zaruthoj/preamp/BOM.ods

Description | Schematic #s | Part Number | Quantity | Price | Ext Price | Link
1000uF cap | C6, C7 | 1189-2588-ND | 3 | 0.64 | 1.92 | http://www.digikey.com/product-detail/en/25ZLS1000MEFC10X20/1189-2588-ND/4977135
Bridge Rectifier | D5 | MB6SCT-ND | 2 | 0.42 | 0.84 | http://www.digikey.com/product-detail/en/MB6S/MB6SCT-ND/965654
INA217 Amp | A1, A2 | 296-13452-5-ND | 2 | 6.77 | 13.54 | http://www.digikey.com/product-detail/en/INA217AIP/296-13452-5-ND/486364
Diode | D1-D4, D7-D10 | 497-3241-1-ND | 10 | 0.23 | 2.3 | http://www.digikey.com/product-detail/en/STTH1L06A/497-3241-1-ND/654610
Trim Pot | RV1, RV2 | 3296W-104LF-ND | 2 | 2.41 | 4.82 | http://www.digikey.com/product-detail/en/3296W-1-104LF/3296W-104LF-ND/1088046
Transformer | T1 | 237-1531-ND | 1 | 7.43 | 7.43 | http://www.digikey.com/product-detail/en/F28-200-C2-B/237-1531-ND/3986378
Opamp | U1, U4 | OPA137NACT-ND | 2 | 2.01 | 4.02 | http://www.digikey.com/product-detail/en/OPA137NA%2F250/OPA137NACT-ND/275823
Positive Power Regulator | U2 | LM7815ACT-ND | 2 | 0.67 | 1.34 | http://www.digikey.com/product-detail/en/LM7815ACT/LM7815ACT-ND/1923052
Negative Power Regulator | U3 | LM7915CT-ND | 2 | 1.61 | 3.22 | http://www.digikey.com/product-detail/en/LM7915CT/LM7915CT-ND/3701357
Tantalum 0805 Cap | C9 | 478-8927-1-ND | 2 | 0.59 | 1.18 | http://www.digikey.com/product-detail/en/TAJR105K020RNJ/478-8927-1-ND/4561793
RCA Jack |  | CP-1432-ND | 2 | 2.02 | 4.04 | http://www.digikey.com/product-detail/en/RCJ-2123/CP-1432-ND/408519
Fuse Holder |  | BF303-ND | 1 | 1.24 | 1.24 | http://www.digikey.com/product-detail/en/BF303/BF303-ND/2330519
Fuse |  | 507-1257-ND | 3 | 0.2 | 0.6 | http://www.digikey.com/product-detail/en/5MF%20250-R/507-1257-ND/1009029
Power Cord |  | Q114-ND | 1 | 2.38 | 2.38 | http://www.digikey.com/product-detail/en/221001-01/Q114-ND/183380
Power Cord Grommet |  | RP454-ND | 1 | 0.254 | 0.254 | http://www.digikey.com/product-detail/en/HG-4/RP454-ND/104937
 |  |  |  |  | 0
 |  |  |  |  | 0
0.1uF 0805 Cap | C3-C5, C8, C12-C14 |  | 7
1uF 0805 Cap | C1, C2, C10, C11 |  | 4
2.2k 0805 Resistor | R1, R2, R5, R6 |  | 4
1k 0805 Resistor | R3, R7 |  | 2
1M 0805 Resistor | R4, R8 |  | 2
 |  |  | Component Cost |  | 49.124
