zaruthoj/preamp/preamp.kicad_pcb

## KiCad design preamp.kicad_pcb (2015-06-21)

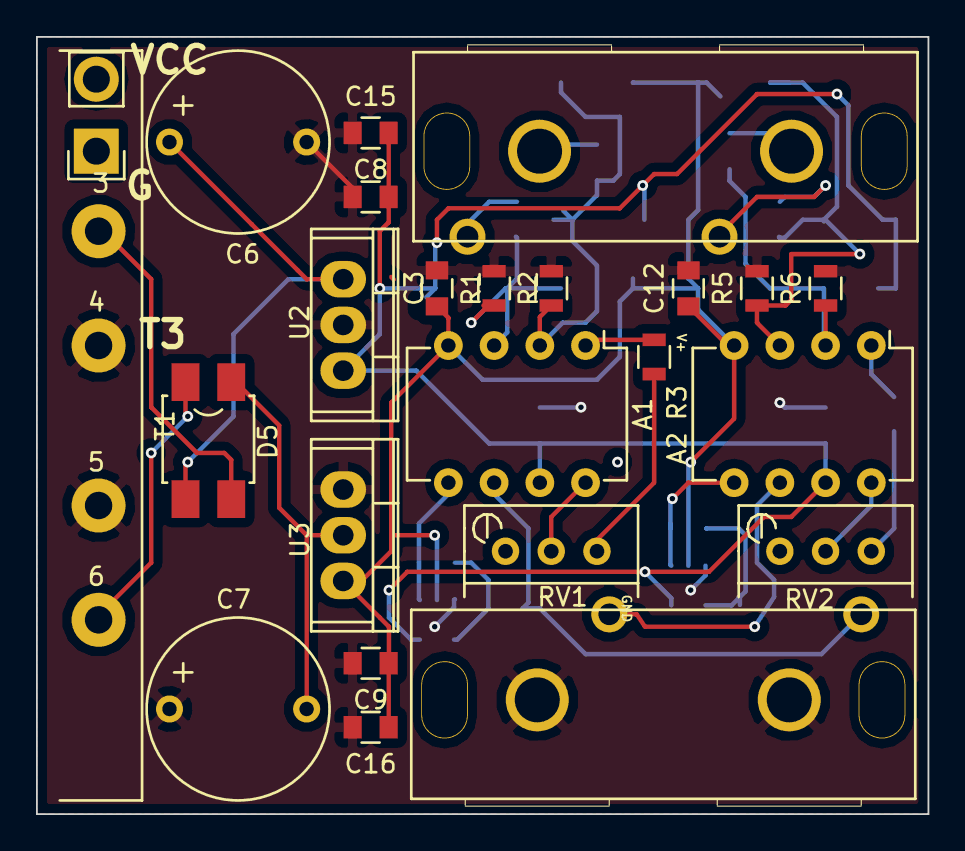
[picture p1: board preamp.kicad_pcb from above]

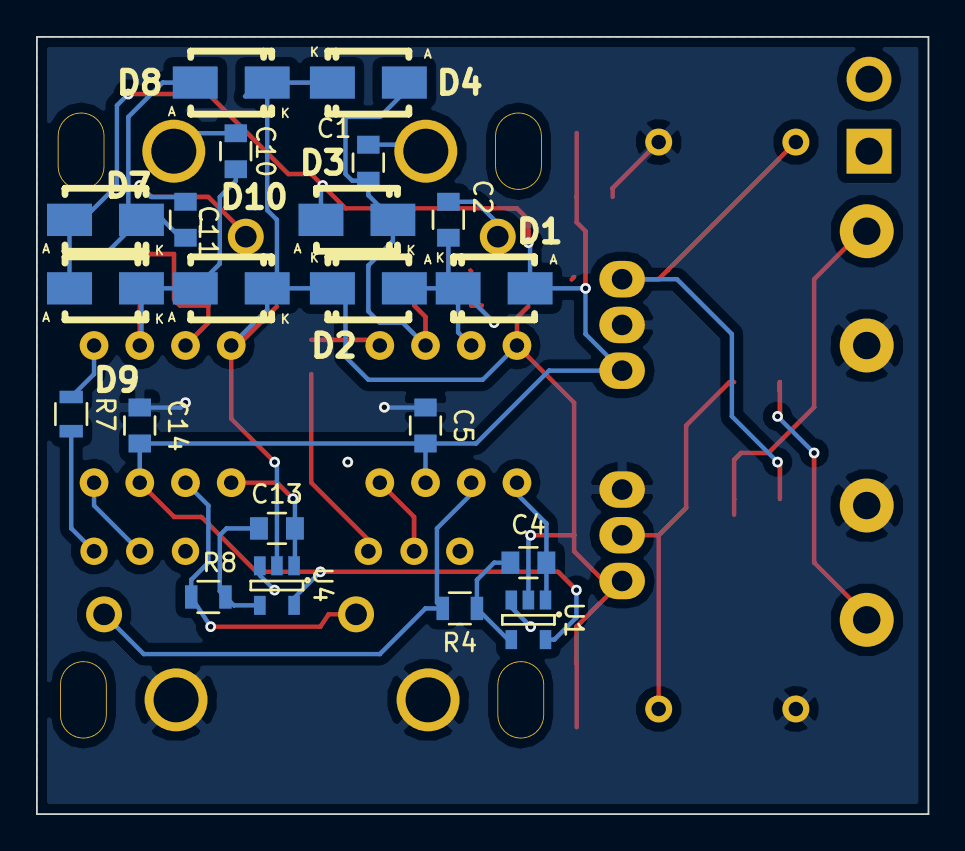
[picture p2: board preamp.kicad_pcb from below]

Board: 2 copper layers, 49.5 x 43.2 mm, 45 parts (21 on the bottom side), 27 nets.

Parts:
A1, A2: INA217; DIP-8_W7.62mm
C1, C2, C10, C11: 1uf; C_0805
C3, C4, C5, C12, C13, C14: 0.1uf; C_0805
C6, C7: 1000uF; preamp_Elko_vert_20x10mm_RM7.5
C8: 0.1uF; C_0805
C9: 1uf t; C_0805
C15: .1uf; C_0805
C16: C_0805
D1, D2, D3, D4, D7, D8, D9, D10: D; Diode-SMA_Standard_RevA_26July2010
D5: Diode_Bridge; Bridge-Rectifier-SOIC-4
P1, P3: CONN_01X04; preamp_RCA_STEREO
P2: CONN_01X02; Power_Pin_Header
R1, R2, R5, R6: 2.2k; R_0805
R3, R7: 1k; R_0805
R4, R8: 1M; R_0805
RV1, RV2: 10k; Potentiometer_Bourns_3296W_3-8Zoll_Inline_ScrewUp
T1: TRANSFO2; preamp_transformer_6pin_half
U1, U4: OPA137N; SOT-23-5
U2: LM7815CT; TO-220
U3: LM7915CT; TO-220

Connections:
+15V: A1.7, A2.7, C5.2, C8.1, C14.2, C15.1, D1.1, D3.1, D7.1, D9.1, U1.5, U2.3, U4.5
-15V: A1.4, A2.4, C3.2, C9.2, C12.2, C16.2, D2.2, D4.2, D8.2, D10.2, U1.2, U3.3, U4.2
GND: C3.1, C5.1, C6.2, C7.1, C8.2, C9.1, C12.1, C14.1, C15.2, C16.1, P3.1, P3.3, R1.2, R2.2, R5.2, R6.2, T1.4, T1.5, U1.3, U2.2, U3.1, U4.3
unnamed: A1.1, R3.2
unnamed: A1.2, C1.1, D3.2, D4.1, R2.1
unnamed: A1.3, C2.1, D1.2, D2.1, R1.1
unnamed: A1.5, C4.2, U1.1
unnamed: A1.6, P3.4, R4.1
unnamed: A1.8, RV1.2
unnamed: A2.1, R7.2
unnamed: A2.2, C10.1, D9.2, D10.1, R6.1
unnamed: A2.3, C11.1, D7.2, D8.1, R5.1
unnamed: A2.5, C13.2, U4.1
unnamed: A2.6, P3.2, R8.1
unnamed: A2.8, RV2.2
unnamed: C1.2, P1.3
unnamed: C2.2, P1.4
unnamed: C4.1, R4.2, U1.4
unnamed: C6.1, D5.3, U2.1
unnamed: C7.2, D5.1, U3.2
unnamed: C10.2, P1.1
unnamed: C11.2, P1.2
unnamed: C13.1, R8.2, U4.4
unnamed: D5.2, T1.6
unnamed: D5.4, T1.3
unnamed: R3.1, RV1.3
unnamed: R7.1, RV2.3
