zaruthoj/preamp/(commit log)

2015-06-08 Initial project files
    [preamp.kicad_pcb, preamp.sch]
2015-06-09 First rev complete.
    [preamp-B_Cu.gbr, preamp-B_Mask.gbr, preamp-B_SilkS.gbr, preamp-Edge_Cuts.gbr, preamp-F_Cu.gbr, preamp-F_Mask.gbr, preamp-F_SilkS.gbr, preamp.drl]
2015-06-09 Add silkscreen labels for IO
    [preamp.kicad_pcb]
2015-06-12 Add PSU and additional channel to schematic and parts
    [BOM.ods, preamp.sch]
2015-06-16 Expand to stereo, add AC power supply. Not done yet.
    [BOM.ods, preamp.kicad_pcb, preamp.sch]
2015-06-16 More work on stereo plus PCB footprint
    [preamp.kicad_pcb]
2015-06-16 More footprint improvements.
    [preamp.kicad_pcb]
2015-06-16 Finish adding PSU and second channel. Ready for fab?
    [preamp.kicad_pcb, preamp.sch]
2015-06-16 Gerber files for PSU stereo
    [preamp-B_Cu.gbr, preamp-B_Mask.gbr, preamp-B_SilkS.gbr, preamp-Edge_Cuts.gbr, preamp-F_Cu.gbr, preamp-F_Mask.gbr, preamp-F_SilkS.gbr, preamp.drl]
2015-06-16 Cleanup a label I missed
    [preamp.kicad_pcb, preamp.sch]
2015-06-17 Add power cable items to BOM and misc layout cleanup.
    [BOM.ods, preamp.kicad_pcb]
2015-06-17 Clean up a couple of stray traces.
    [preamp.kicad_pcb]
2015-06-21 Fix transformer value to adjust for RMS vs peak to peak voltage. Add extra filtering caps at PSU output. Fix the diode bridge pads.
    [BOM.ods, preamp.kicad_pcb, preamp.sch]
2015-06-21 Fix trim pot values to allow for min gain of 1.1x. Also generate gerbers.
    [BOM.ods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]
2015-06-21 Final ordered version on Oshpark.
    [preamp-B_Cu.gbr, preamp-B_Mask.gbr, preamp-B_SilkS.gbr, preamp-Edge_Cuts.gbr, preamp-F_Cu.gbr, preamp-F_Mask.gbr, preamp-F_SilkS.gbr, preamp.drl]
